gururajbhupal/ECE3400-Team15/index.md

## Welcome to Team 15

# Team Contract
You can view the contract here [contract](https://github.com/gururajbhupal/ECE3400-Team15/blob/master/contract.pdf) 

# Labs
[Lab 1- Microcontrollers](/ECE3400-Team15/Lab1)  
[Lab 2- Analog circuitry and FFT](/ECE3400-Team15/Lab2)  
[Lab 3- System Integration and Radio Communication](/ECE3400-Team15/Lab3)  
[Lab 4- FPGA and Vision](/ECE3400-Team15/Lab4)

# Milestones
[Milestone 1](/ECE3400-Team15/Milestone1)  
[Milestone 2](/ECE3400-Team15/Milestone2)  
[Milestone 3](/ECE3400-Team15/Milestone3)  
[Milestone 4](/ECE3400-Team15/Milestone4) 

[Final Robot](/ECE3400-Team15/FinalRobot)
