gururajbhupal/ECE3400-Team15/Milestone2/Info.rtf

Calibrate: used to find delay time for function adjust() so that turns would be smoother.

test_wall: used to test wall thresholds and find appropriate thresholds.

test_IR: used to ensure IR code was working properly

WallandLineFollow: Traversing the maze via right hand wall following while line following

Milestone_2_final: Traversing the maze via right hand wall following while line following AND avoiding robots while ignoring decoys
