gururajbhupal/ECE3400-Team15/FinalRobot/Media/D07board.jpg

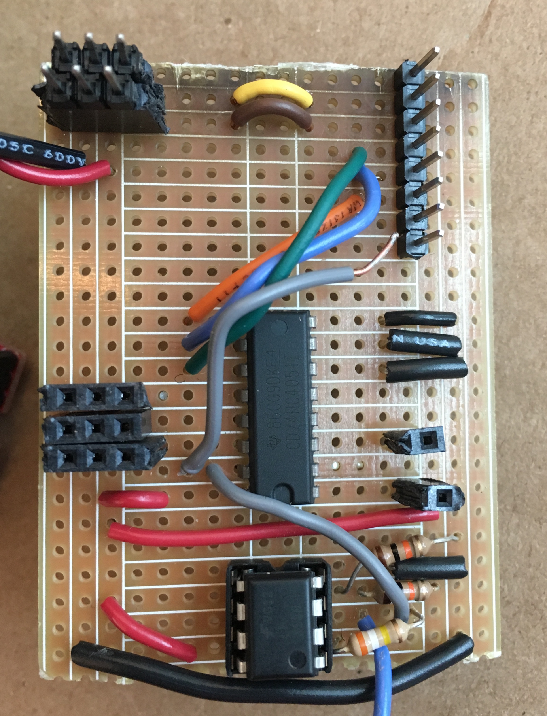
FinalRobot/Media/D07board.jpg
