gururajbhupal/ECE3400-Team15/FinalRobot/Media/IMG_8885.jpg

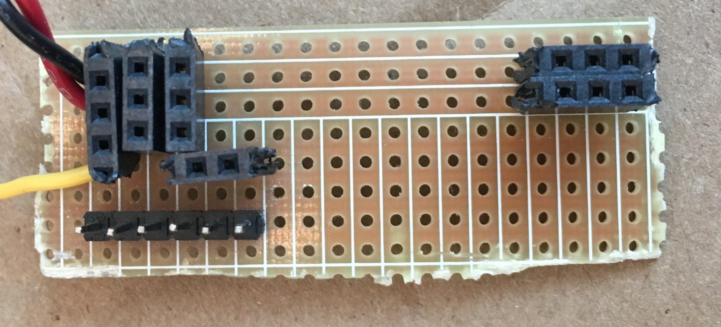
FinalRobot/Media/IMG_8885.jpg
