gururajbhupal/ECE3400-Team15/FinalRobot/Media/IRboard.JPG

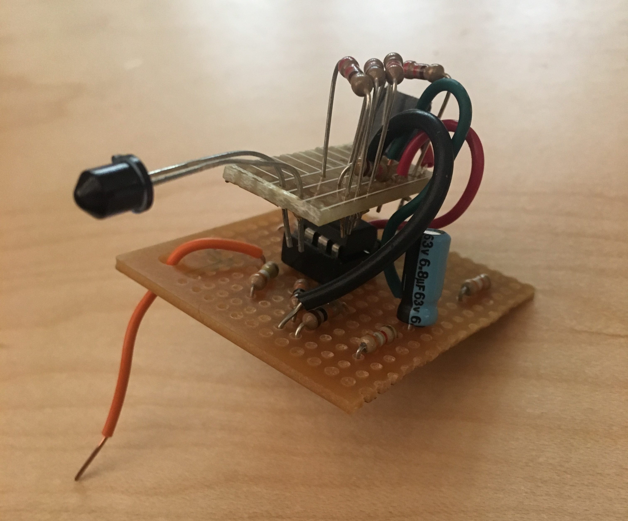
FinalRobot/Media/IRboard.JPG
