gururajbhupal/ECE3400-Team15/Lab1/Media/InternalLEDThumbnail.PNG

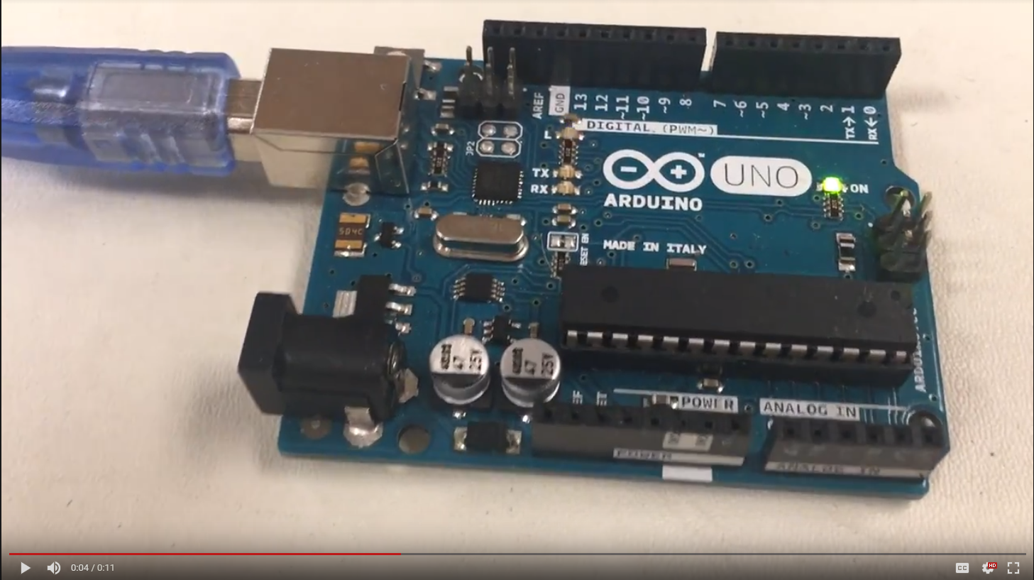
Lab1/Media/InternalLEDThumbnail.PNG
