gururajbhupal/ECE3400-Team15/Lab3/Media/audio_detect.png

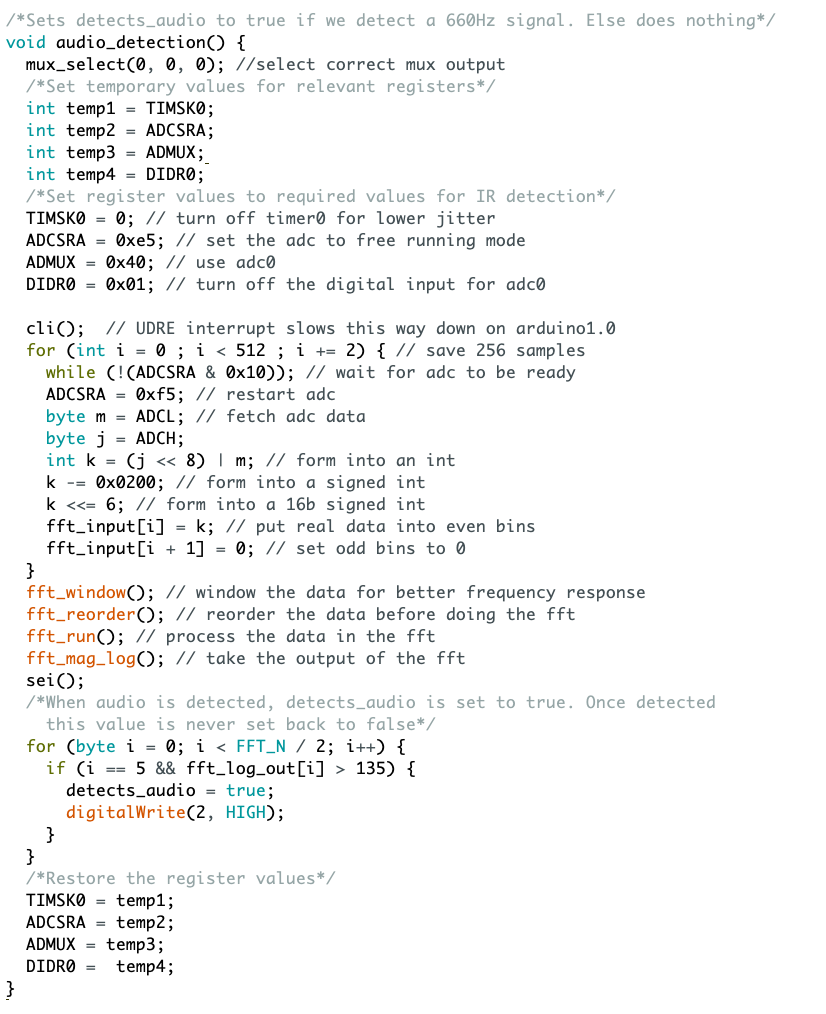
Lab3/Media/audio_detect.png
