gururajbhupal/ECE3400-Team15/Lab3/Media/robot_to_base_code.PNG

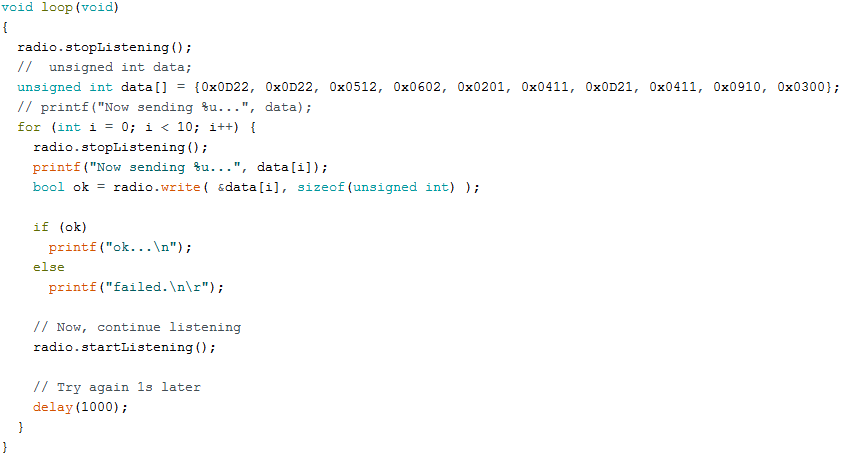
Lab3/Media/robot_to_base_code.PNG
