gururajbhupal/ECE3400-Team15/Milestone2/Media/line_fololow.PNG

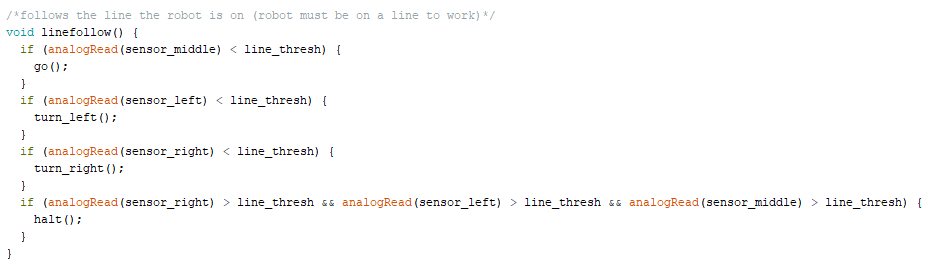
Milestone2/Media/line_fololow.PNG
