gururajbhupal/ECE3400-Team15/Milestone4/Media/IMG_0800.JPG

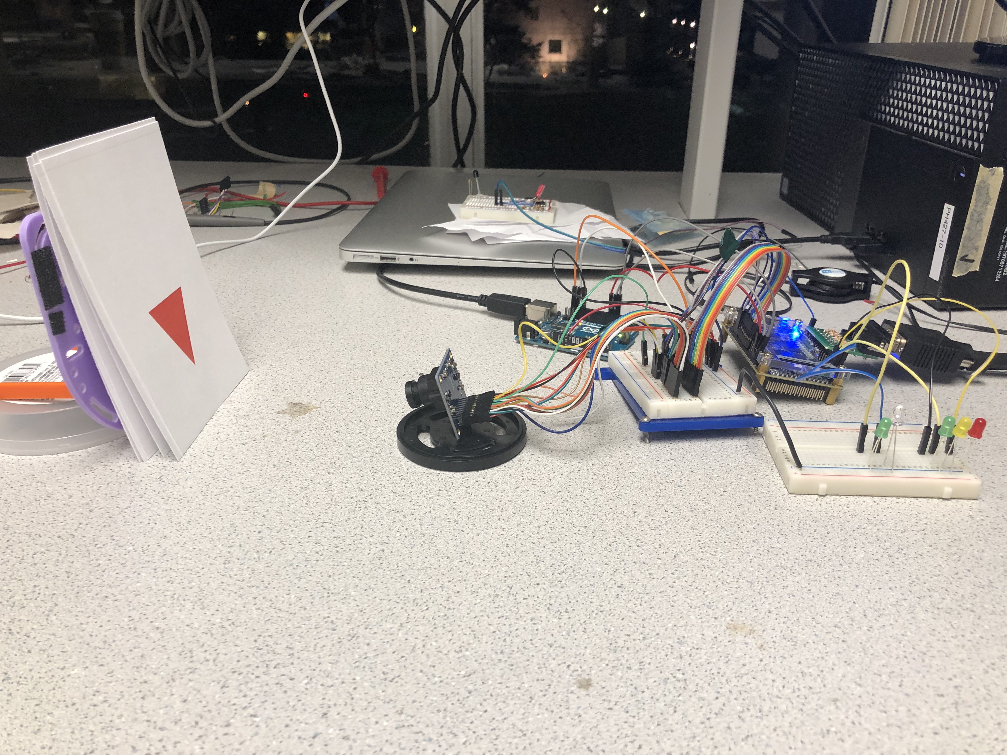
Milestone4/Media/IMG_0800.JPG
