gururajbhupal/ECE3400-Team15/Milestone4/Media/IMG_2287.JPG

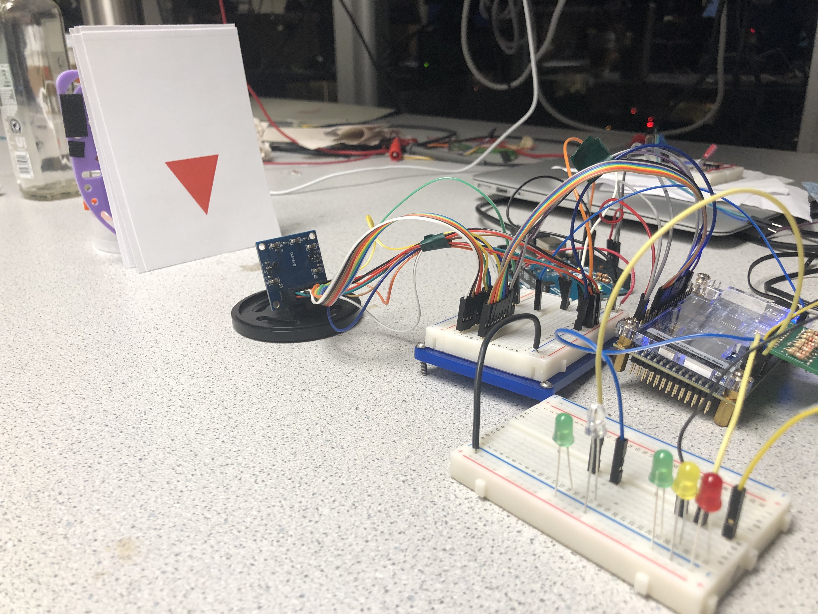
Milestone4/Media/IMG_2287.JPG
