gururajbhupal/ECE3400-Team15/Milestone4/Media/set.JPG

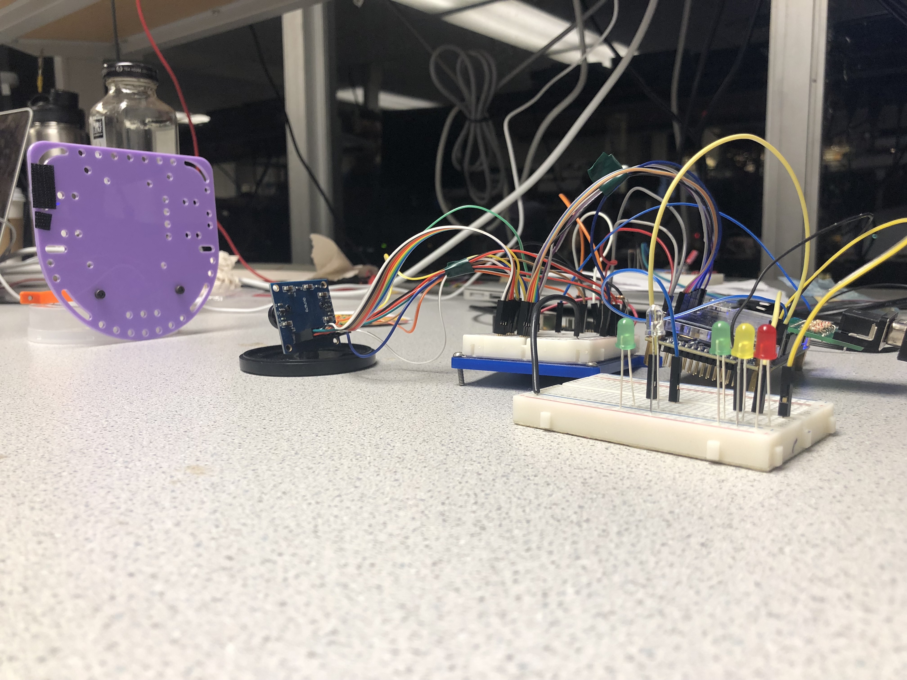
Milestone4/Media/set.JPG
