gururajbhupal/ECE3400-Team15/Lab3/Media/Test-Maze.png

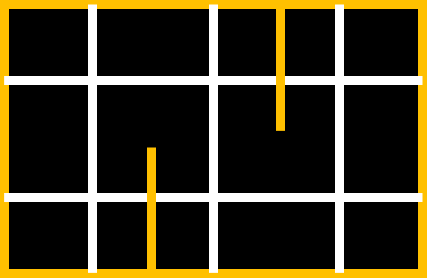
Lab3/Media/Test-Maze.png
