gururajbhupal/ECE3400-Team15/(commit log)

2018-10-04 IR/Audio code
    Working code to show either IR, Audio, or both on LEDs.
2018-10-18 Lab3_with_audio
    Milestone_2_code that only works with 660Hz detected ... kinda
2018-10-22 UPDATED PIN ASSIGNMENTS
    Note the servos changed pins, as well as the mux select
2018-10-22 A LOT READ CHANGES
    Mux pins changed
    Servo pins changed
    radio plugged in
    changed IR and audio detection to output blank signal at the end (DOESN'T WORK OTHERWISE)
    DO NOT MODIFY Lab3_audio - it is our working demo code.
    MODIFY - Lab3_final or create a new copy of Lab3_audio and name to something else
    [3x3.ino, Lab3_final.ino, Lab3_with_audio.ino]
2018-10-23 NOMOREDWRITE
    Got rid of all digital writes for pins 2 and 3 (which used to be LEDS) which likely caused mux issues which conflicted with some maze traversal issues we were having
    [Lab3_final.ino]
2018-11-10 added I2C image
2018-11-15 Lab3Final Changes
    Changed wall threshold and updated mux delay switching time
2018-11-15 Nitty gritty stuff, fixed inconsistincies
    [Lab3_final.ino]
2018-11-15 Fixed old code
    Added info file and fixed lab 1 code with changes we made along the way for added consistency
    [follow_line.ino]
2018-11-18 I think this is done!
    Make sure you download the StackArray library and put it in your libraries folder for Arduino!
2018-11-27 Now correctly uses queue instead of stack for paths
    [FLR_dfs.ino]
2018-11-27 Reverted back to an old version before I did stupid shit
    [Base2GUI.ino, Calibrate.ino, FLR_dfs.ino, IR_and_Audio_code.ino, Lab3_final.ino, Lab3_with_audio.ino, Milestone_2_final.ino, WallandLineFollow.ino]
2018-11-30 11/30 update
    Added locals l, f, and r to find_path(). Added Coordinate back to keep track of node behind us. Added error() function to help identify when things go wrong.
2018-12-04 added pcb picture and test
2018-12-04 sensor changes
